jruelli/pluto_docu/docs/3_pluto_pico/5_pluto_pico_proximity.rst

Proximity sensors of Pluto_pico
-------------------------------

The pico uses VL53L0x sensors for proximity and distance sensing.
