jruelli/pluto_docu/docs/3_pluto_pico/fritzing_proxy.png

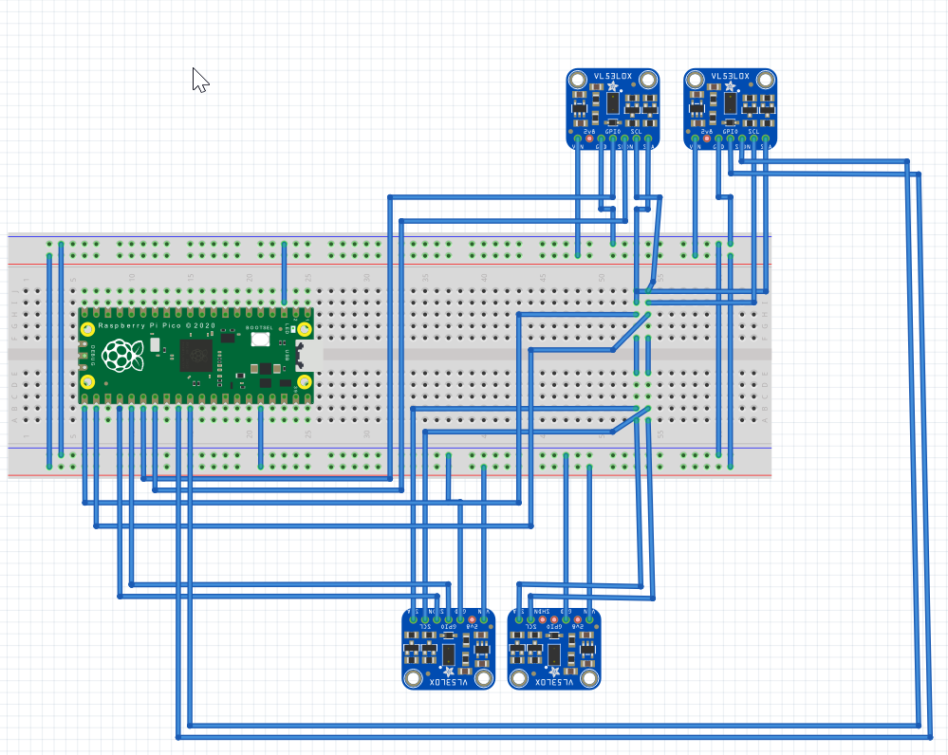
docs/3_pluto_pico/fritzing_proxy.png
