jruelli/pluto_docu/docs/3_pluto_pico/pluto_pico-Overview.drawio.png

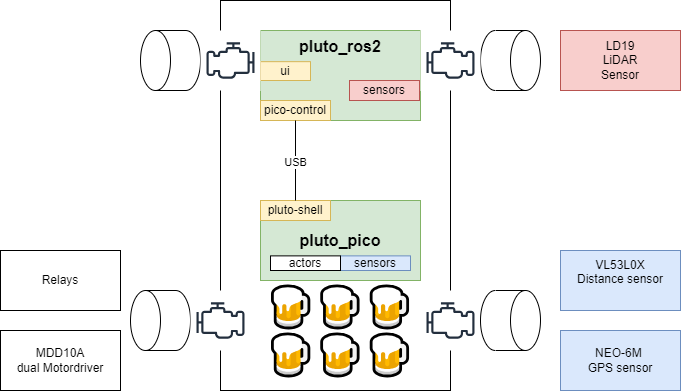
docs/3_pluto_pico/pluto_pico-Overview.drawio.png
