jruelli/pluto_docu/docs/3_pluto_pico/pluto_pico.drawio.png

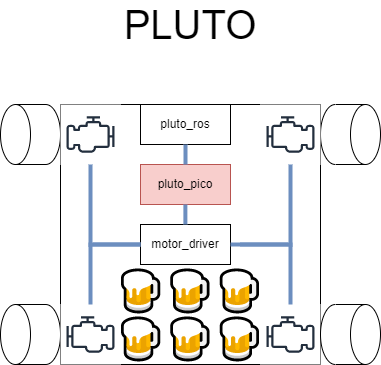
docs/3_pluto_pico/pluto_pico.drawio.png
