jruelli/pluto_docu/ideaOfStruct.png

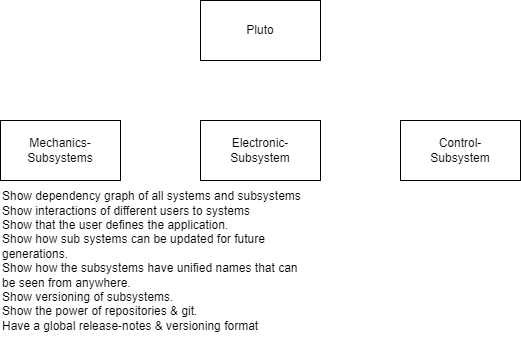
ideaOfStruct.png
