jruelli/pluto_docu/pluto_control.png

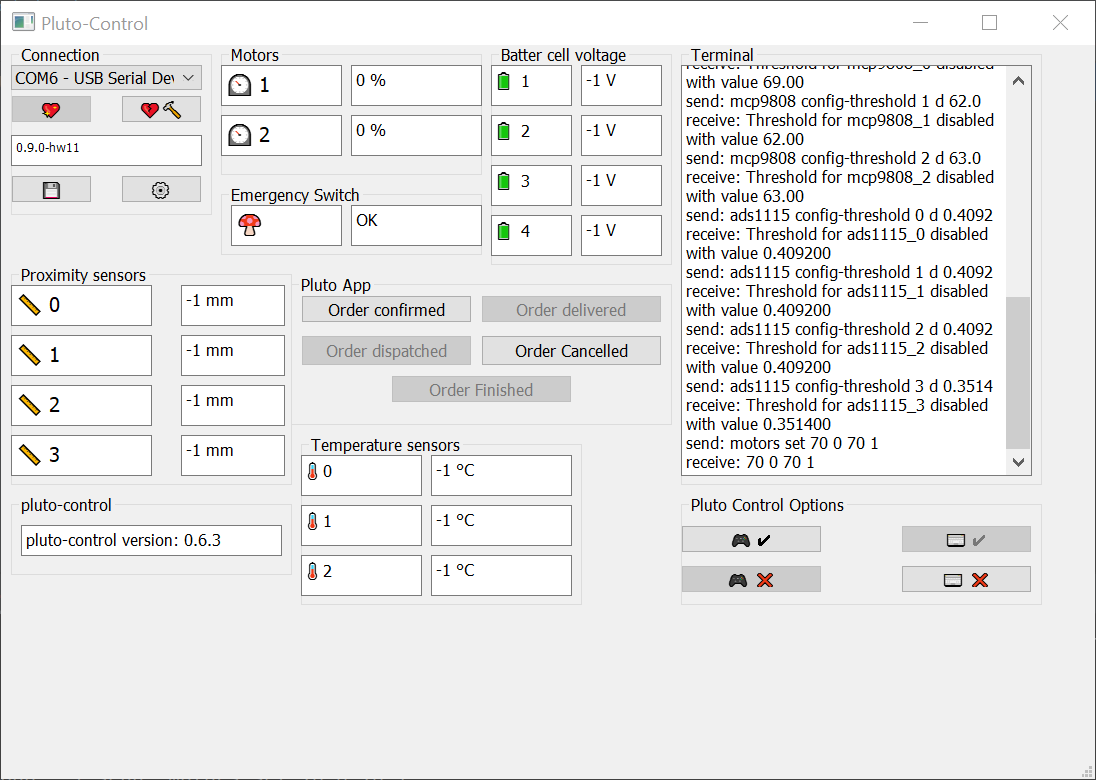
pluto_control.png
