jruelli/pluto_docu/(list of files, drawings)

Other design files:
docs/3_pluto_pico/pluto_prototype.fzz
