jruelli/pluto_docu/docs/1_getting_started/0_getting_started.rst

Getting Started
===============
Great that you want to learn more about Pluto!
In this section, we will provide everything that
is needed to get started with the Pluto project.

.. include:: 1_getting_started_pluto_pico.rst
.. include:: 2_getting_started_pluto_control.rst
