jruelli/pluto_docu/(commit log)

2023-12-18 add chapter about PLuto Pico
2023-12-28 Add description of relays usage.
2024-01-03 adding docu for relays
2024-01-03 adding docu for motors
2024-01-09 update bom for temp and compass sensor
2024-01-09 add fritzing model of pico_pluto
    [pluto_prototype.fzz]
2024-01-09 add step-down converter and ads1115 for analog measurement
    [pluto_prototype.fzz]
2024-01-09 add docu for relay support
2024-02-01 exchange compass sensor through bno055
    [pluto_prototype.fzz]
2024-02-01 add motor control and developing with pico
2024-02-01 replace compass sensor with bno055
2024-06-10 fix structure
    [pluto_prototype.fzz]
